jyelewis/sapling-cpu/readme.md

## Sapling CPU

Commands
 - `make test`
 - `make run-sam SAM=pkg6_software/hello.sam`
 - `make run-sam SAM=pkg6_software/primes.sam`

Viewing waveforms
 - `uv run pytest pkg3_cpu_hdl/testbench/test_testbench.py`
 - `surfer build/cocotb/testbench/testbench.fst`
