jyelewis/sapling-cpu/pkg1_design/ISA/High level design.md

## High level design

- This is an '8-bit CPU' with a 16-bit address bus.
- Due to its 16 bit address bus, it supports a maximum of 64KB of memory.
- Program memory & data memory is shared.
- It has 8 registers, each 8 bits wide.
- The CPU supports a simple instruction set: see [Instructions](./Instructions.md) for details.
- IO is not memory mapped, but instead uses a separate (3 bit) IO address space.
- There are 8 IO devices, each of which can be read from or written 8 bits at a time via the IN and OUT instructions.
- Each IO device has an interrupt line that can be triggered by the device to signal the CPU that it needs attention. When an interrupt line is triggered, the corresponding bit in the pending interrupts register is set, and if interrupts are enabled (IF flag is set), the CPU will jump to the interrupt vector to handle the interrupt.
- The CPU has a stack pointer (SP) which is a 16 bit register that points to the top of the stack in memory. The stack grows downwards (SP is decremented when pushing, and incremented when popping).
- The CPU has a flags register which is 8 bits wide, and contains the following flags:
  - Zero flag (ZF): set if the result of an arithmetic or logical operation is zero
  - Negative flag (NF): set if the result of an arithmetic or logical operation is negative (most significant bit is 1)
  - Carry flag (CF): set if the result of an arithmetic operation is too large to fit in 8 bits (i.e. if there is a carry out of the most significant bit)
  - Overflow flag (OF): set if the result of a signed arithmetic operation produces a value outside the representable range (-128 to 127), i.e. if adding two positive numbers yields a negative result or adding two negative numbers yields a positive result
  - Interrupt enable flag (IF): set if interrupts are enabled, and cleared if interrupts are disabled. When an interrupt line is triggered, the CPU will ALWAYS set the corresponding bit in the pending interrupts register, but it will only handle the interrupt if the IF flag is set. This allows software to disable interrupts when it needs to perform critical sections of code that should not be interrupted.
- The CPU has a pending interrupts register which is 8 bits wide, and contains a bit for each of the 8 IO devices. When an interrupt is triggered by an IO device, the corresponding bit in the pending interrupts register is set. The CPU can then check this register to determine which interrupts are pending, and handle them accordingly.
- The CPU has 1 vector: Address 0x0000, which is both the reset & interrupt vector. When the CPU is reset, it will start executing instructions from this address. When an interrupt is triggered, the CPU will also jump to this address to handle the interrupt. The interrupt handler can then check the pending interrupts register to determine which interrupt was triggered, and handle it accordingly.

### Reset state

On reset, all general purpose registers are set to zero, the flags register is cleared (all flags off), there are no pending interrupts, and the program counter is set to 0x0000. The stack pointer is initialised to 0x0000; since the stack grows downward (SP is decremented before writing), the first PUSH will write to 0xFFFF, placing the stack at the top of memory.

### CALL/RET stack behavior

The CALL instruction pushes the 16-bit return address (address of the instruction after the CALL) onto the stack. SP is decremented by 2: the high byte is pushed first (at SP-1), then the low byte (at SP-2). CALL does not save flags or registers — the caller must PUSH them manually if needed.

The RET instruction pops 2 bytes from the stack in reverse order: the low byte from SP, then the high byte from SP+1. SP is incremented by 2. The reconstructed 16-bit address is loaded into the program counter.

### Branch and jump offsets

All branch and jump-relative instructions use a signed offset measured in instructions (not bytes). An offset of +1 means skip 1 instruction forward; an offset of -3 means jump back 3 instructions. Since each instruction is 2 bytes, the actual byte offset applied to the PC is the signed offset multiplied by 2. The offset is relative to the PC of the next instruction (i.e. the instruction after the branch/jump).
