jyelewis/sapling-cpu/pkg2_pcbs/sapling-test-board/sapling-test-board.kicad_pcb

## KiCad design pkg2_pcbs/sapling-test-board/sapling-test-board.kicad_pcb (2026-04-22)

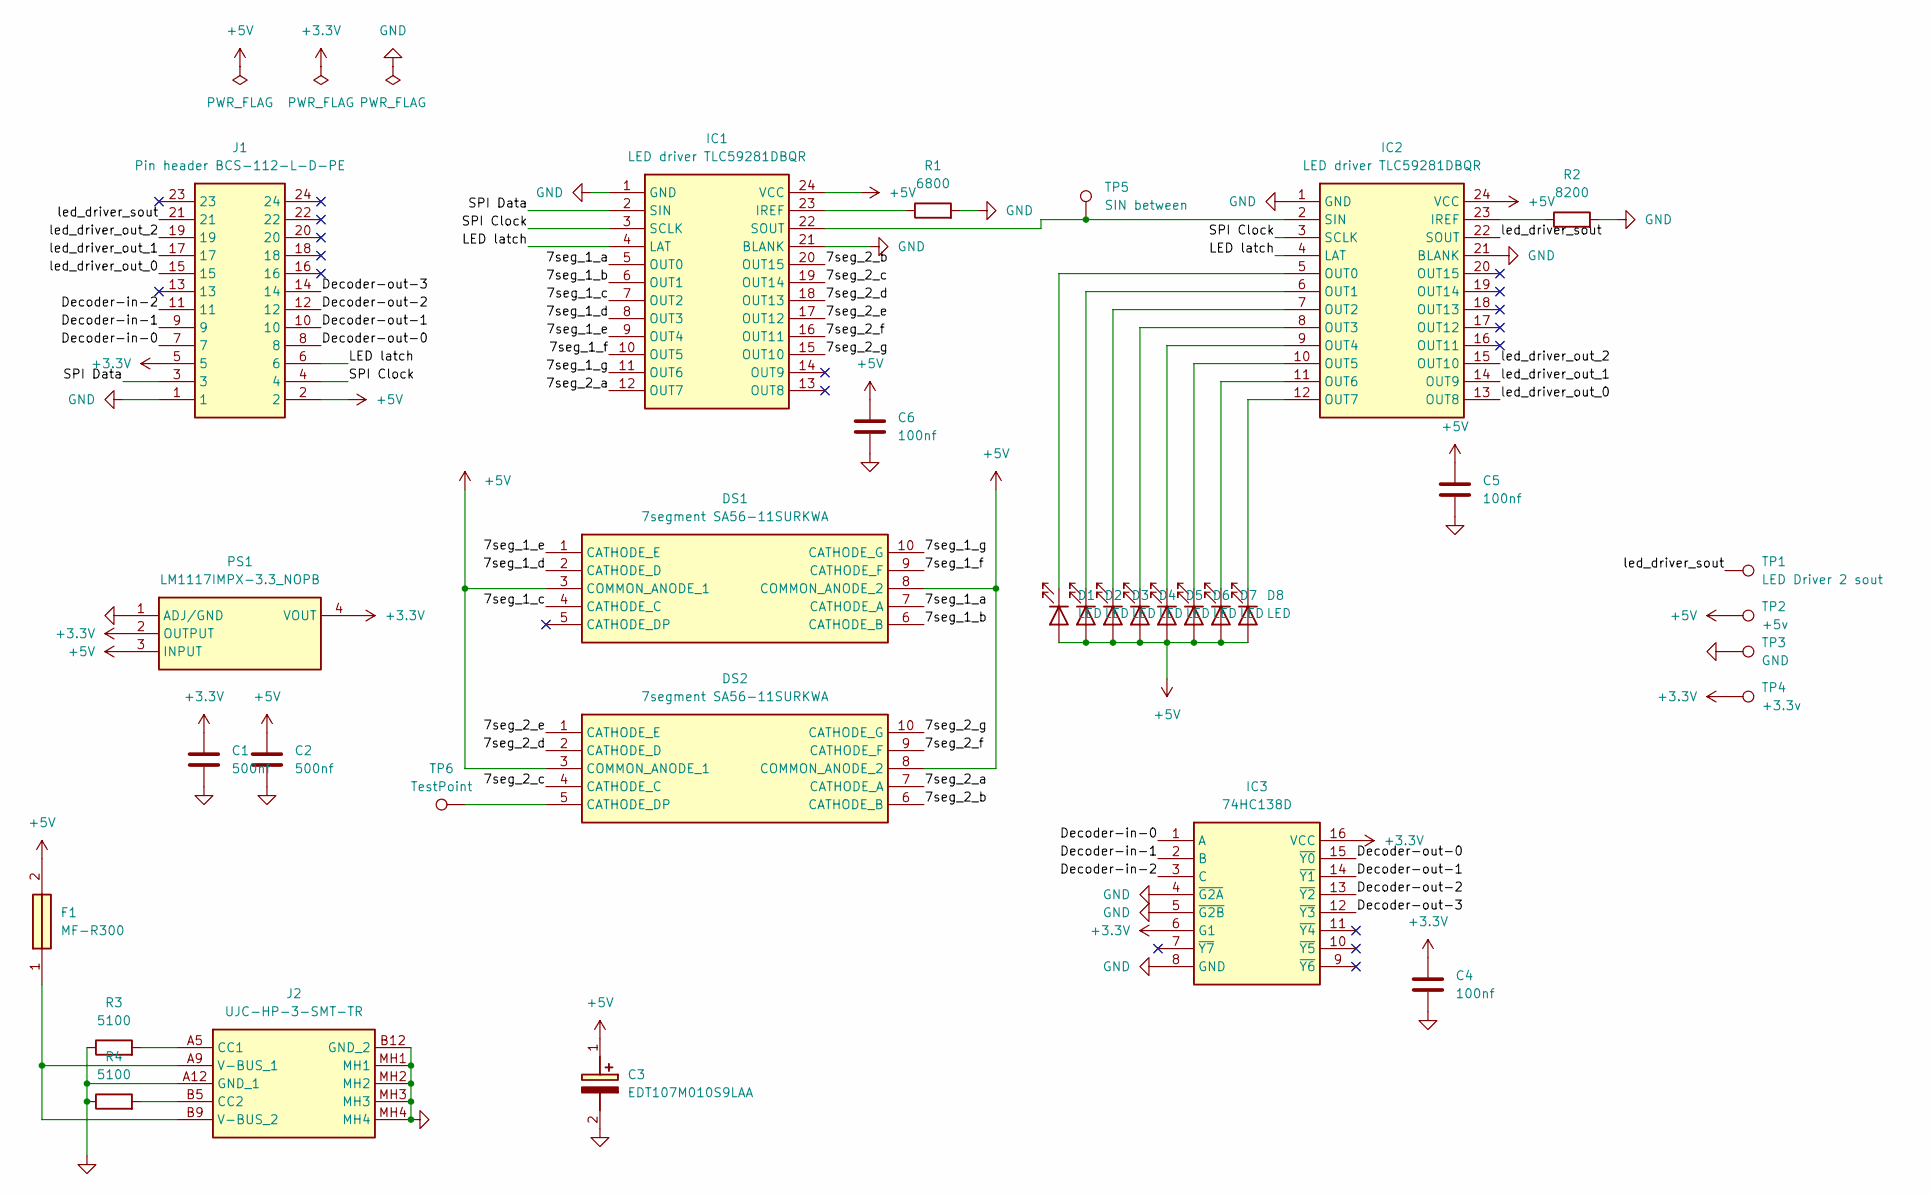
[picture p1: schematic sapling-test-board.kicad_sch]

Parts:
C1, C2: 500nf; C_0805_2012Metric
C3: EDT107M010S9LAA; CAPAE830X650N; Mouser Part Number 80-EDT107M010S9LAA
C4, C5, C6: 100nf; C_0805_2012Metric
D1, D2, D3, D4, D5, D6, D7, D8: LED; LED_D5.0mm
DS1, DS2: 7segment SA56-11SURKWA; DIPS1524W75P254L1270H825Q10N; Mouser Part Number 604-SA56-11CGKWA
F1: MF-R300; MFR300; Mouser Part Number 652-MFR300
IC1, IC2: LED driver TLC59281DBQR; SOP64P600X175-24N; Mouser Part Number 595-TLC59281DBQR
IC3: 74HC138D; SOIC127P600X175-16N; Mouser Part Number 757-74HC138D
J1: Pin header BCS-112-L-D-PE; BCS-112-XXX-D-PE; Mouser Part Number 200-BCS112LDPE
J2: UJC-HP-3-SMT-TR; UJCHP3SMTTR; Mouser Part Number 490-UJC-HP-3-SMT-TR
PS1: LM1117IMPX-3.3_NOPB; SOT230P700X180-4N; Mouser Part Number 926-LM1117IMPX33NOPB
R1: 6800; R_0805_2012Metric
R2: 8200; R_0805_2012Metric
R3, R4: 5100; R_0805_2012Metric
TP1: LED Driver 2 sout; TestPoint_Pad_D4.0mm
TP2: +5v; TestPoint_Pad_D4.0mm
TP3: GND; TestPoint_Pad_D4.0mm
TP4: +3.3v; TestPoint_Pad_D4.0mm
TP5: SIN between; TestPoint_Pad_D4.0mm
TP6: TestPoint; TestPoint_Pad_D4.0mm

Connections:
+3.3V: C1.2, C4.2, IC3.6 (G1), IC3.16 (VCC), J1.5, PS1.2 (OUTPUT), PS1.4 (VOUT), TP4.1 (1_1)
+5V: C2.2, C3.1 (+), C5.2, C6.2, D1.2 (A), D2.2 (A), D3.2 (A), D4.2 (A), D5.2 (A), D6.2 (A), D7.2 (A), D8.2 (A), DS1.3 (COMMON_ANODE_1), DS1.8 (COMMON_ANODE_2), DS2.3 (COMMON_ANODE_1), DS2.8 (COMMON_ANODE_2), F1.2, IC1.24 (VCC), IC2.24 (VCC), J1.2, PS1.3 (INPUT), TP2.1 (1_1)
/7seg_1_a: DS1.7 (CATHODE_A), IC1.5 (OUT0)
/7seg_1_b: DS1.6 (CATHODE_B), IC1.6 (OUT1)
/7seg_1_c: DS1.4 (CATHODE_C), IC1.7 (OUT2)
/7seg_1_d: DS1.2 (CATHODE_D), IC1.8 (OUT3)
/7seg_1_e: DS1.1 (CATHODE_E), IC1.9 (OUT4)
/7seg_1_f: DS1.9 (CATHODE_F), IC1.10 (OUT5)
/7seg_1_g: DS1.10 (CATHODE_G), IC1.11 (OUT6)
/7seg_2_a: DS2.7 (CATHODE_A), IC1.12 (OUT7)
/7seg_2_b: DS2.6 (CATHODE_B), IC1.20 (OUT15)
/7seg_2_c: DS2.4 (CATHODE_C), IC1.19 (OUT14)
/7seg_2_d: DS2.2 (CATHODE_D), IC1.18 (OUT13)
/7seg_2_e: DS2.1 (CATHODE_E), IC1.17 (OUT12)
/7seg_2_f: DS2.9 (CATHODE_F), IC1.16 (OUT11)
/7seg_2_g: DS2.10 (CATHODE_G), IC1.15 (OUT10)
/Decoder-in-0: IC3.1 (A), J1.7
/Decoder-in-1: IC3.2 (B), J1.9
/Decoder-in-2: IC3.3 (C), J1.11
/Decoder-out-0: IC3.15 (~Y0), J1.8
/Decoder-out-1: IC3.14 (~Y1), J1.10
/Decoder-out-2: IC3.13 (~Y2), J1.12
/Decoder-out-3: IC3.12 (~Y3), J1.14
/LED latch: IC1.4 (LAT), IC2.4 (LAT), J1.6
/SPI Clock: IC1.3 (SCLK), IC2.3 (SCLK), J1.4
/SPI Data: IC1.2 (SIN), J1.3
/led_driver_out_0: IC2.13 (OUT8), J1.15
/led_driver_out_1: IC2.14 (OUT9), J1.17
/led_driver_out_2: IC2.15 (OUT10), J1.19
/led_driver_sout: IC2.22 (SOUT), J1.21, TP1.1 (1_1)
GND: C1.1, C2.1, C3.2 (-), C4.1, C5.1, C6.1, IC1.1 (GND), IC1.21 (BLANK), IC2.1 (GND), IC2.21 (BLANK), IC3.4 (~G2A), IC3.5 (~G2B), IC3.8 (GND), J1.1, J2.A12 (GND_1), J2.B12 (GND_2), J2.MH1, J2.MH2, J2.MH3, J2.MH4, PS1.1 (ADJ/GND), R1.2, R2.2, R3.1, R4.1, TP3.1 (1_1)
unnamed: D1.1 (K), IC2.5 (OUT0)
unnamed: D2.1 (K), IC2.6 (OUT1)
unnamed: D3.1 (K), IC2.7 (OUT2)
unnamed: D4.1 (K), IC2.8 (OUT3)
unnamed: D5.1 (K), IC2.9 (OUT4)
unnamed: D6.1 (K), IC2.10 (OUT5)
unnamed: D7.1 (K), IC2.11 (OUT6)
unnamed: D8.1 (K), IC2.12 (OUT7)
unnamed: DS2.5 (CATHODE_DP), TP6.1 (1_1)
unnamed: IC1.23 (IREF), R1.1
unnamed: IC1.22 (SOUT), IC2.2 (SIN), TP5.1 (1_1)
unnamed: IC2.23 (IREF), R2.1
unnamed: J2.A5 (CC1), R3.2
unnamed: J2.B5 (CC2), R4.2
unnamed: F1.1, J2.A9 (V-BUS_1), J2.B9 (V-BUS_2)

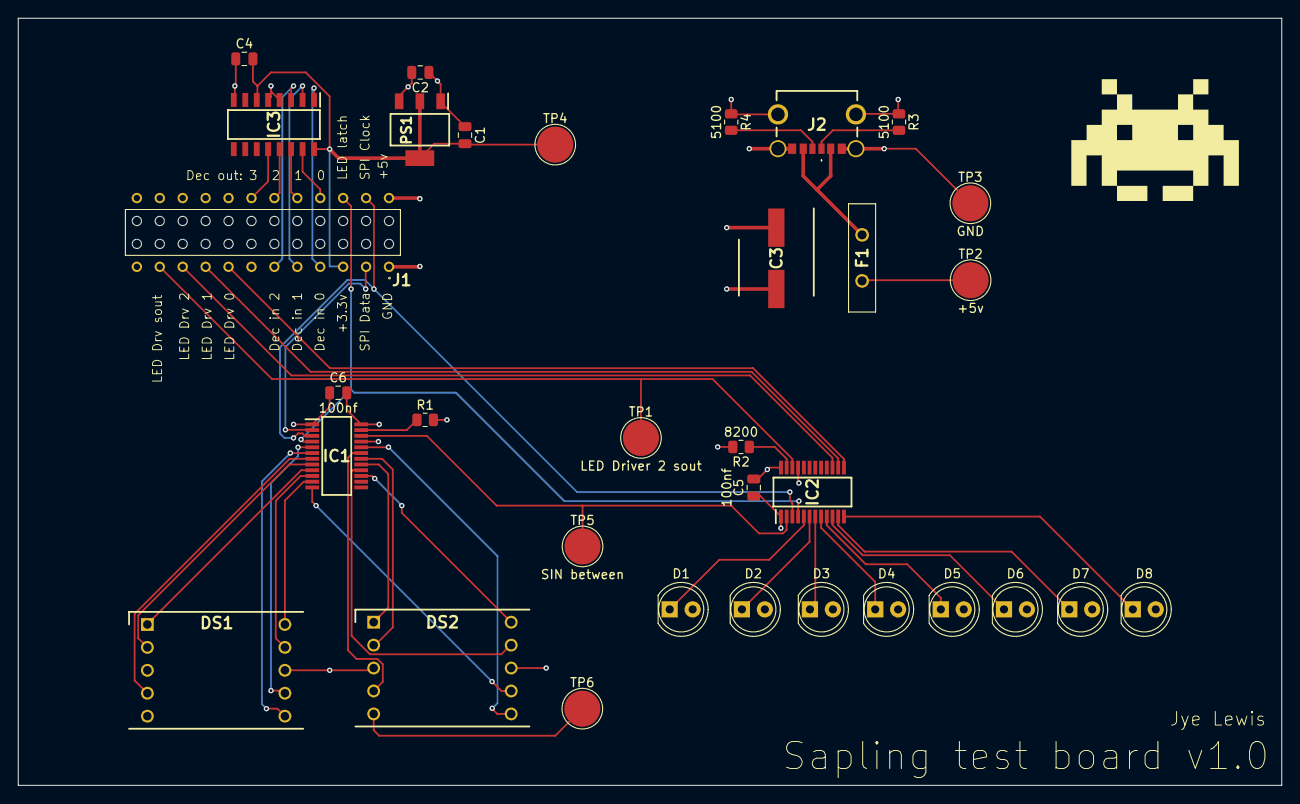
[picture p2: board sapling-test-board.kicad_pcb from above]

Board: 4 copper layers, 140.0 x 85.0 mm, 33 parts (0 on the bottom side), 46 nets.
