jyelewis/sapling-cpu/pkg3_cpu_hdl/boards/icesugar/top.sv

module top
  import IceSugar_HID_RGB_LED::*;
(
    input  logic ICESUGAR_CLK,
    output logic ICESUGAR_LED_R,
    output logic ICESUGAR_LED_G,
    output logic ICESUGAR_LED_B,

    output logic ICESUGAR_P2_1,
    output logic ICESUGAR_P2_2,
    output logic ICESUGAR_P2_3

    //    output logic [7:0] ICESUGAR_PMOD2_LED
);

  logic generated_clk;
  logic clk;

  // iCESugar clock is 12 MHz - divide down to get a 1hz clock
  clock_divider #(
      //      .DIVISOR(12_000_000)
      .DIVISOR(120_00)
  ) clock_divider (
      .clk_in (ICESUGAR_CLK),
      .clk_out(generated_clk),
      .reset  (1'b0)
  );

  SB_GB u_gb_step (
      .USER_SIGNAL_TO_GLOBAL_BUFFER(generated_clk),
      .GLOBAL_BUFFER_OUTPUT        (clk)
  );

  logic [15:0] requested_memory_address;

  sapling_cpu_core sapling_cpu_core (
      .clk(clk),
      .reset(1'b0),
      .memory_address(requested_memory_address),
      .memory_read_data(16'h0000),  // forever read nops
      .memory_write_data(),
      .memory_write_enable(),
      .memory_ready(1'b1)
  );

  color_t        color;
  logic   [15:0] tick_number;

  always_ff @(posedge clk) begin
    color <= color_t'(color + 1);  // wraps 000 -> 111 -> 000
    tick_number <= tick_number + 1;
  end

  IceSugar_HID_RGB_LED rgb_led (
      .RGB_color(color),
      .ICESUGAR_LED_R(ICESUGAR_LED_R),
      .ICESUGAR_LED_G(ICESUGAR_LED_G),
      .ICESUGAR_LED_B(ICESUGAR_LED_B)
  );

  //  IceSugar_pmod_LEDs pmod_leds (
  //      .ICESUGAR_PMOD2_LED(ICESUGAR_PMOD2_LED),
  //      //      .value(tick_number)
  //      .value(requested_memory_address[7:0])
  //  );

  // re-latch
  logic [7:0] io_tick;
  always_ff @(posedge clk) begin
    io_tick <= io_tick + 1;
  end

  // driving the test board
  sapling_test_board_controller sapling_test_board_controller (
      .clk(clk),  // TODO: should this be our clock? do we need to sync it?
      .reset(0),
      .update_display(io_tick == 0),  // update on our clock

      .green_hex(8'b01010101),
      .red_hex(tick_number[15:8]),
      .leds(tick_number[15:8]),

      .pin_spi_clk  (ICESUGAR_P2_1),
      .pin_spi_data (ICESUGAR_P2_2),
      .pin_led_latch(ICESUGAR_P2_3)
  );
endmodule
