jyelewis/sapling-cpu/pkg3_cpu_hdl/boards/icesugar/board_modules/IceSugar_cells_bb.sv

// verilog_lint: waive-start module-filename

// all available cells here:
// ~/dev-thirdparty/oss-cad-suite/share/yosys/ice40/cells_sim.v

(* blackbox *)
module SB_GB (
    input  USER_SIGNAL_TO_GLOBAL_BUFFER,
    output GLOBAL_BUFFER_OUTPUT
);
endmodule
