jyelewis/sapling-cpu/(commit log)

2026-04-19 Structure to program different boards with unique IO
2026-04-20 Components test board
    [sapling-test-board.kicad_pcb, sapling-test-board.kicad_sch]
2026-04-20 Auto routed PCB
    [sapling-test-board.kicad_pcb]
2026-04-22 Hand routed PCB
    [sapling-test-board.kicad_pcb, sapling-test-board.kicad_sch]
2026-04-22 BB PCB review
    [sapling-test-board.kicad_pcb, sapling-test-board.kicad_sch]
2026-04-22 Test board PCB ordered
    [sapling-test-board.kicad_pcb, sapling-test-board.kicad_sch]
2026-04-23 Super basic assembler
2026-04-23 Assembler file outputs
2026-04-23 Implement carry modes into assembler
2026-04-23 Clean up the assembler & vm
2026-04-23 fmt, move into prefixed sub-dirs
    [sapling-test-board.kicad_pcb, sapling-test-board.kicad_sch]
2026-04-26 Respect memory stalls
2026-04-28 Split more cleanly into 3 pipeline stages
2026-05-02 Test board pin out
2026-05-03 Messy but functional test board controller
2026-05-04 Implement the rest of the ALU ops, SP relative writes, find problems in pipeline when microcode stalling
    [control_unit.sv, sapling_cpu_core.sv, test_testbench.py, types.sv]
2026-05-04 Memory operations now take 3 cycles, until we can work out how to keep the pipeline in place during stalls
    [control_unit.sv, test_testbench.py]
